sittner/ovng-build/README.md

OVNG-BUILD
==========
This repo contains the stuff to build a OpenVarioNG:

- KiCad project for the PCB
- FreeCAD drawing that includes the sensor distribution block and a printable housing
- buildroot env to build the sd card image for installation
