sittner/ovng-build/electronics/partlist.ods

Item | Qty | Reference(s) | Value | LibPart | Footprint | Manu | PartNo | Dist | DistPart
1 | 1 | BT501 | CR-1220 | Device:Battery_Cell | modusoft:BatteryHolder_HARWIN_S8411-45R_CR1220 | Harwin | S8411-45R | Mouser | 855-S8411-45R
2 | 25 | C101, C203, C210, C302, C307, C406, C407, C408, C409, C501, C502, C605, C606, C609, C801, C802, C803, C901, C902, C903, C917, C918, C919, C920, C924 | 100n | Device:C | Capacitor_SMD:C_0805_2012Metric |  | GPC0805104
3 | 8 | C102, C103, C104, C105, C106, C107, C108, C109 | 1000u/25V | Device:CP | Capacitor_THT:CP_Radial_D10.0mm_P5.00mm
4 | 4 | C202, C204, C205, C206 | 4u7/50V | Device:C | Capacitor_SMD:C_1206_3216Metric | Murata | GRM31CR71H475KA12L | Mouser | 81-GRM31CR71H475KA2L
5 | 1 | C207 | 1u/50V | Device:C | Capacitor_SMD:C_0805_2012Metric | Murata | GRM21BR71H105KA12L | Mouser | 81-GRM155R6YA105KE1D
6 | 1 | C208 | 10n | Device:C | Capacitor_SMD:C_0805_2012Metric |  | GPC0805103
7 | 1 | C209 | 180u/16V | Device:CP | Capacitor_SMD:CP_Elec_10x7.9 | Sanyo | 16SVP180MX | Mouser | 667-16SVP180MX
8 | 1 | C211 | 47u/16V | Device:C | Capacitor_SMD:C_1210_3225Metric | Murata | GRM32ER61C476KE15L | Mouser | 81-GRM32EC81C476KE5L
9 | 26 | C301, C303, C304, C305, C306, C308, C309, C310, C401, C402, C403, C404, C601, C602, C603, C604, C607, C608, C909, C910, C913, C914, C915, C916, C922, C923 | 1u | Device:C | Capacitor_SMD:C_0805_2012Metric |  | GPC0805105
10 | 2 | C904, C905 | 2u2 | Device:C | Capacitor_SMD:C_0805_2012Metric |  | GPC0805225
11 | 2 | C906, C921 | 10u | Device:C | Capacitor_SMD:C_0805_2012Metric | Murata | GRM21BR61C106KE15K | Mouser | 81-GRM21BR61C106KE5K
12 | 2 | C907, C908 | 2n2 | Device:C | Capacitor_SMD:C_0805_2012Metric |  | GPC0805222
13 | 2 | C911, C912 | 470n | Device:C | Capacitor_SMD:C_0805_2012Metric |  | GPC0805474
14 | 1 | D101 | S3BB-13-F | Device:D | Diode_SMD:D_SMB | Diodes Incorporated | ES3BB-13-F | Mouser | 621-ES3BB-F
15 | 1 | D102 | VS-20BQ030HM3/5BT | Device:D_Schottky | Diode_SMD:D_SMB | Vishay Semiconductors | VS-20BQ030HM3/5BT | Mouser | 78-VS-20BQ030HM35BT
16 | 1 | D201 | SS36-E3/57T | Device:D_Schottky | Diode_SMD:D_SMC | Vishay Semiconductors | SS36-E3/57T | Mouser | 625-SS36-E3
17 | 4 | D301, D302, D303, D304 | S1BB-13-F | Device:D | Diode_SMD:D_SMB | Diodes Incorporated | S1BB-13-F | Mouser | 621-S1BB-F
18 | 1 | D901 | PESD3V3L4UG | Power_Protection:PESD3V3L4UG | Package_TO_SOT_SMD:SOT-353_SC-70-5 | Nexperia | PESD3V3L4UG,115 | Mouser | 771-PESD3V3L4UG-T/R
19 | 1 | D902 | MBR0540 | Device:D_Schottky | Diode_SMD:D_SOD-123 | ON Semiconductor | MBR0540T1G | Mouser | 863-MBR0540T1G
20 | 1 | D903 | MM3Z24VT1G | Device:D_Zener | Diode_SMD:D_SOD-323 | ON Semiconductor | MM3Z24VT1G | Mouser | 863-MM3Z24VT1G
21 | 1 | F101 | 1.5A | Device:Polyfuse | Fuse:Fuse_2920_7451Metric | Littelfuse | 2920L150DR | Mouser | 576-2920L150
22 | 5 | F301, F302, F303, F304, F801 | 300mA | Device:Polyfuse | Fuse:Fuse_1812_4532Metric | Littelfuse | MINISMDC030F-2 | Mouser | 650-MINISMDC030F-2
24 | 1 | J101 | Power 12V | Connector:Conn_01x02_Male | modusoft:TerminalBlock_Phoenix_PTSM-0,5-2-HH-2.5-SMD_1x02-1MP_P2.50mm_Vertical | Phoenix | 1778764 | Mouser | 651-1778764
 |  |  |  |  |  | Phoenix | 1778832 | Mouser | 651-1778832
25 | 1 | J301 | COM1 | Connector:8P8C | modusoft:Modular-MEBP8-8S |  |  | Reichelt | MEBP 8-8S
26 | 1 | J302 | COM2 | Connector:8P8C | modusoft:Modular-MEBP8-8S |  |  | Reichelt | MEBP 8-8S
27 | 1 | J303 | COM3 | Connector:8P8C | modusoft:Modular-MEBP8-8S |  |  | Reichelt | MEBP 8-8S
28 | 1 | J304 | COM4 | Connector:8P8C | modusoft:Modular-MEBP8-8S |  |  | Reichelt | MEBP 8-8S
29 | 1 | J701 | BeagleBone J9 | Connector_Generic:Conn_02x23_Odd_Even | Connector_PinSocket_2.54mm:PinSocket_2x23_P2.54mm_Vertical
30 | 1 | J702 | BeagleBone J8 | Connector_Generic:Conn_02x23_Odd_Even | Connector_PinSocket_2.54mm:PinSocket_2x23_P2.54mm_Vertical
31 | 1 | J705 | BeagleBone J1 | Connector_Generic:Conn_01x06 | Connector_PinHeader_2.54mm:PinHeader_1x06_P2.54mm_Vertical
32 | 1 | J801 | OneWire | Connector:4P4C | modusoft:Modular-MEBP4-4S |  |  | Reichelt | MEBP 4-4S
33 | 1 | J802 | ENC0 | Connector:4P4C | modusoft:Modular-MEBP4-4S |  |  | Reichelt | MEBP 4-4S
34 | 1 | J803 | ENC1 | Connector:4P4C | modusoft:Modular-MEBP4-4S |  |  | Reichelt | MEBP 4-4S
35 | 1 | J901 | Audio Out | Connector:6P6C | modusoft:Modular-MEBP6-6S |  |  | Reichelt | MEBP 6-6S
36 | 1 | J902 | DISP | Connector_Generic:Conn_01x40 | Connector_FFC-FPC:TE_4-1734839-0_1x40-1MP_P0.5mm_Horizontal | TE Connectivity | 4-1734592-0 | Mouser | 571-4-1734592-0
37 | 2 | L201, L203 | 600R@100MHz/2A | Device:L_Core_Ferrite | modusoft:WE_742792040 | Würth | WE_CBF 742792040 | Mouser | 710-742792040
38 | 1 | L202 | 22u | Device:L_Core_Ferrite | Inductor_SMD:L_Wuerth_WE-PDF_Handsoldering | Würth | WE_PDF 7447798221 | Mouser | 710-7447798221
39 | 4 | L401, L601, L602, L603 | 1k@100MHz | Device:L_Core_Ferrite | Inductor_SMD:L_0805_2012Metric | Würth | 742792096 | Mouser | 710-742792096
40 | 1 | L901 | 10u | Device:L_Core_Ferrite | Inductor_SMD:L_Wuerth_MAPI-2510 | Wurth Elektronik | 74404024100 | Mouser | 710-74404024100
41 | 1 | Q301 | BC846 | Transistor_BJT:BC846 | Package_TO_SOT_SMD:SOT-23 | ON Semiconductor | BC846BLT1G | Mouser | 863-BC846BLT1G
42 | 1 | Q801 | BSS84 | Transistor_FET:BSS84 | Package_TO_SOT_SMD:SOT-23 | ON Semiconductor | BSS84 | Mouser | 512-BSS84
43 | 1 | R101 | 120k | Device:R | Resistor_SMD:R_0805_2012Metric |  | GPR0805120k
44 | 13 | R102, R301, R601, R602, R603, R604, R605, R606, R802, R803, R901, R909, R943 | 10k | Device:R | Resistor_SMD:R_0805_2012Metric |  | GPR080510k
45 | 4 | R103, R104, R402, R403 | 4k7 | Device:R | Resistor_SMD:R_0805_2012Metric |  | GPR08054k7
46 | 1 | R201 | 61k9 | Device:R | Resistor_SMD:R_0805_2012Metric | Panasonic | ERJ-6ENF6192V | Mouser | 667-ERJ-6ENF6192V
47 | 1 | R202 | 82k | Device:R | Resistor_SMD:R_0805_2012Metric |  | GPR080582k
48 | 2 | R203, R906 | 20k | Device:R | Resistor_SMD:R_0805_2012Metric |  | GPR080520k
49 | 7 | R302, R303, R907, R908, R910, R911, R941 | 100k | Device:R | Resistor_SMD:R_0805_2012Metric |  | GPR0805100k
50 | 2 | R401, R801 | 200k | Device:R | Resistor_SMD:R_0805_2012Metric |  | GPR0805200k
51 | 3 | R804, R912, R913 | 100R | Device:R | Resistor_SMD:R_0805_2012Metric |  | GPR0805100R
52 | 1 | R805 | 22R | Device:R | Resistor_SMD:R_0805_2012Metric |  | GPR080522R
53 | 2 | R902, R903 | 470R | Device:R | Resistor_SMD:R_0805_2012Metric |  | GPR0805470R
54 | 2 | R904, R905 | 27k | Device:R | Resistor_SMD:R_0805_2012Metric |  | GPR080527k
55 | 1 | R942 | 2R7 | Device:R | Resistor_SMD:R_0805_2012Metric |  | GPR08052R7
56 | 5 | RN801, RN802, RN803, RN804, RN805 | 22R | Device:R_Pack04 | Resistor_SMD:R_Array_Concave_4x0603 | Panasonic | EXB-V8V220JV | Mouser | 667-EXB-V8V220JV
57 | 1 | U201 | LM22670M-5_0 | mds-vreg:LM22670M-5_0 | modusoft:HSOP-8-1EP_3.9x4.9mm_P1.27mm_EP2.41x3.1mm_ThermalVias | Texas Instruments | LM22670MRE-5.0/NOPB | Mouser | 926-LM22670MRE50NOPB
58 | 2 | U301, U302 | MAX3232 | Interface_UART:MAX3232 | Package_SO:SOIC-16_3.9x9.9mm_P1.27mm | Texas Instruments | MAX3232EID | Mouser | 595-MAX3232EID
59 | 2 | U401, U402 | MCP1700-1802E_SOT23 | Regulator_Linear:MCP1700-1802E_SOT23 | Package_TO_SOT_SMD:SOT-23 | Microchip Technology | MCP1700T-1802E/TT | Mouser | 579-MCP1700T1802E/TT
60 | 2 | U403, U801 | PCA9306 | Interface:PCA9306 | Package_SO:SSOP-8_2.95x2.8mm_P0.65mm | Texas Instruments | PCA9306DCTR | Mouser | 595-PCA9306DCTR
61 | 1 | U404 | ICM20948 | mds-misc:ICM20948 | modusoft:QFN-24-1EP_3x3mm_P0.4mm_EP1.75x1.6mm_NP | TDK InvenSense | ICM-20948 | Mouser | 410-ICM-20948
62 | 1 | U501 | DS1338-33 | Timer_RTC:DS1307Z+ | Package_SO:SOIC-8_3.9x4.9mm_P1.27mm | Maxim Integrated | DS1338Z-33+T&R | Mouser | 700-DS1338Z-33T&R
63 | 1 | U502 | 24LC01 | Memory_EEPROM:24LC01 | Package_SO:SOIC-8_3.9x4.9mm_P1.27mm | Microchip Technology | 24LC01B-I/SN | Mouser | 579-24LC01B-I/SN
64 | 4 | U601, U602, U605, U902 | MCP1700-3302E_SOT23 | Regulator_Linear:MCP1700-3302E_SOT23 | Package_TO_SOT_SMD:SOT-23 | Microchip Technology | MCP1700T-3302E/TT | Mouser | 579-MCP1700T3302E/TT
65 | 2 | U603, U604 | MS5611 | mds-misc:MS5611 | Package_LGA:LGA-8_3x5mm_P1.25mm | Measurement Specialties | MS561101BA03-50 | Mouser | 824-MS561101BA03-50
66 | 1 | U606 | AMS5915 | mds-misc:AMS5915 | modusoft:AMS5915 |  |  | Amsys GmbH & Co. KK | AMS5915-0050-D-N
67 | 1 | U802 | DS2482-100 | mds-misc:DS2482-100 | Package_SO:SOIC-8_3.9x4.9mm_P1.27mm | Maxim Integrated | DS2482S-100+ | Mouser | 700-DS2482S-100
68 | 1 | U901 | PCM5101A | Audio:PCM5101 | Package_SO:TSSOP-20_4.4x6.5mm_P0.65mm | Texas Instruments | PCM5101APWR | Mouser | 595-PCM5101APWR
69 | 1 | U903 | LM4990MM | Amplifier_Audio:LM4990MM | Package_SO:TSSOP-8_3x3mm_P0.65mm | Texas Instruments | LM4990MM/NOPB | Mouser | 926-LM4990MM/NOPB
70 | 1 | U904 | TS3A24159DGSR | Analog_Switch:TS3A24159DGSR | Package_SO:TSSOP-10_3x3mm_P0.5mm | Texas Instruments | TS3A24159DGSR | Mouser | 595-TS3A24159DGSR
71 | 1 | U905 | SN65HVDA540 | Interface_CAN_LIN:TJA1049T-3 | Package_SO:SOIC-8_3.9x4.9mm_P1.27mm | Texas Instruments | SN65HVDA540QDR | Mouser | 595-SN65HVDA540QDR
72 | 1 | U906 | FAN5333B | Regulator_Switching:SC4503TSK | Package_TO_SOT_SMD:TSOT-23-5 | ON Semiconductor | FAN5333BSX | Mouser | 512-FAN5333BSX
73 | 1 | Y501 | 32.768kHz/12.5pF | Device:Crystal | Crystal:Crystal_SMD_3215-2Pin_3.2x1.5mm | ECS | ECS-.327-12.5-34B-TR | Mouser | 520-327-12.5-34B
