sittner/ovng-build/mechanics/sensor-block.stp

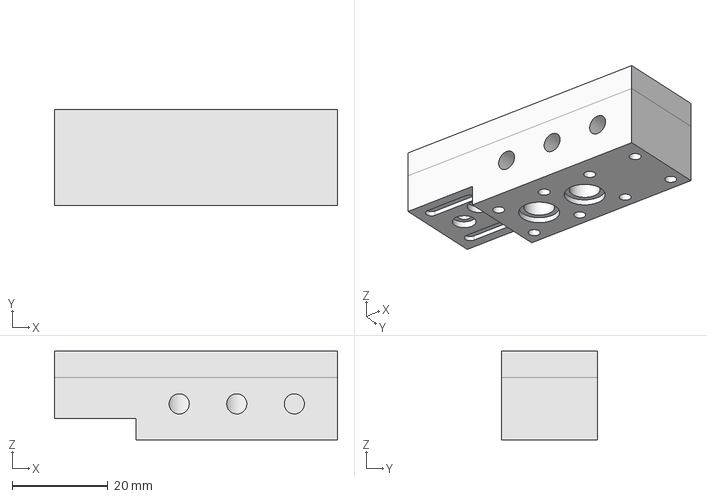
[picture p1: CAD file, 2022-04-04]
mechanics/sensor-block.stp
59.0 x 20.0 x 18.5 mm
