sittner/ovng-build/mechanics/housing-base.stl

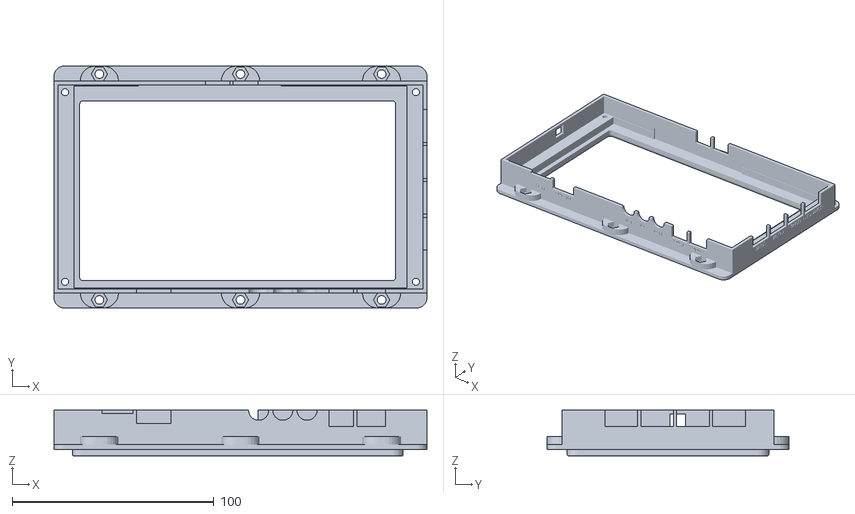
[picture p2: CAD file, 2020-12-04]
mechanics/housing-base.stl
185.0 x 120.0 x 22.6
