sittner/ovng-build/mechanics/housing-top.stl

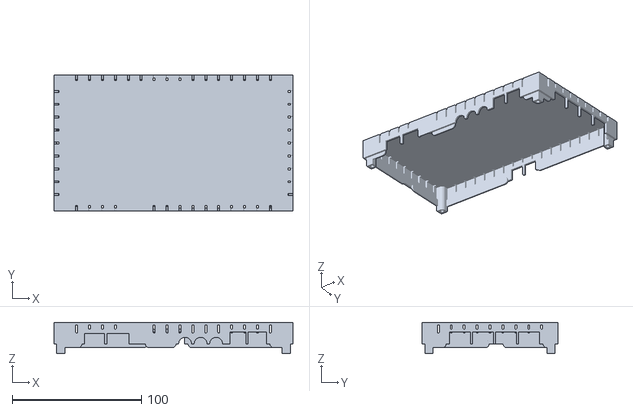
[picture p3: CAD file, 2020-12-04]
mechanics/housing-top.stl
185.0 x 105.0 x 24.0
