sittner/ovng-build/mechanics/display-spacer.stl

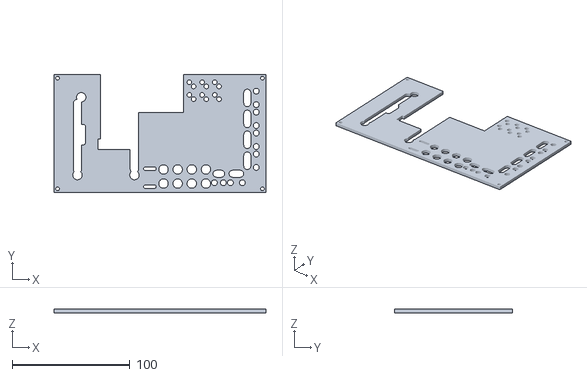
[picture p4: CAD file, 2020-12-01]
mechanics/display-spacer.stl
180.0 x 100.0 x 3.00
