sittner/ovng-build/(list of files, cad)

Other CAD files:
mechanics/SensorBlock.FCStd
mechanics/sensor-block.stl
