sittner/ovng-build/electronics/schematics.pdf

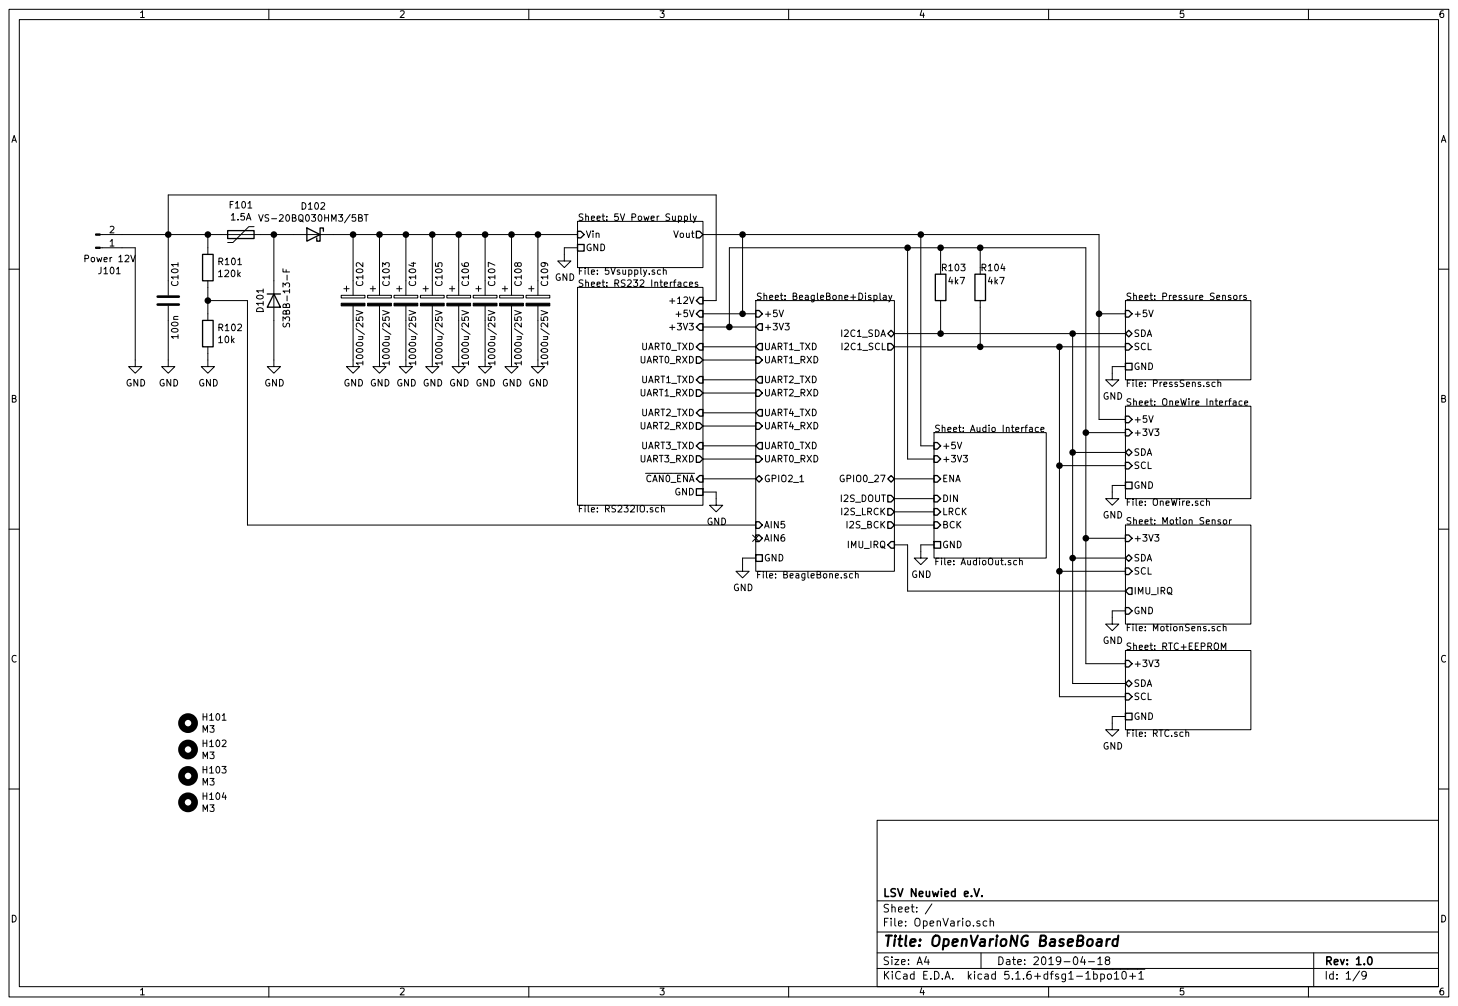
[picture p5: page 1]

SCL Sheet: Pressure Sensors File: PressSens.sch +5V

Sheet: OneWire Interface File: OneWire.sch GND
+3V3 SDA
SCL Sheet: Motion Sensor File: MotionSens.sch +3V3 GND

Sheet: Audio Interface File: AudioOut.sch +5V GND

Sheet: RTC+EEPROM
File: RTC.sch +3V3 GND
SDA

File: OpenVario.sch Sheet: / LSV Neuwied e.V.

Id: 1/9 Title: OpenVarioNG BaseBoard

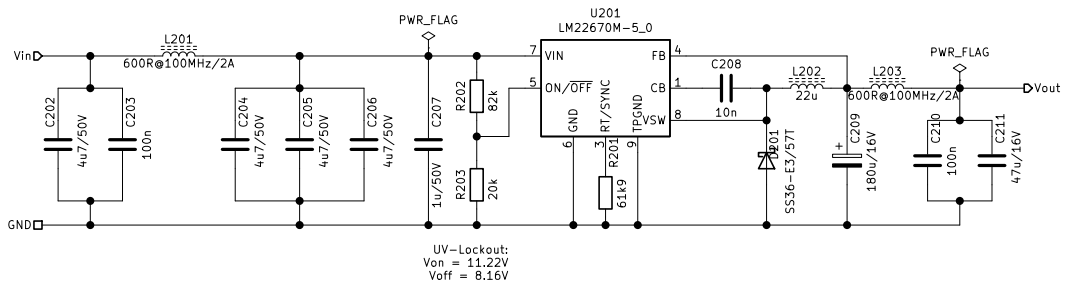
[picture p6: page 2]

3 FB 4 ON/OFF 5 GND

File: 5Vsupply.sch
Id: 2/9 Title: OpenVarioNG BaseBoard

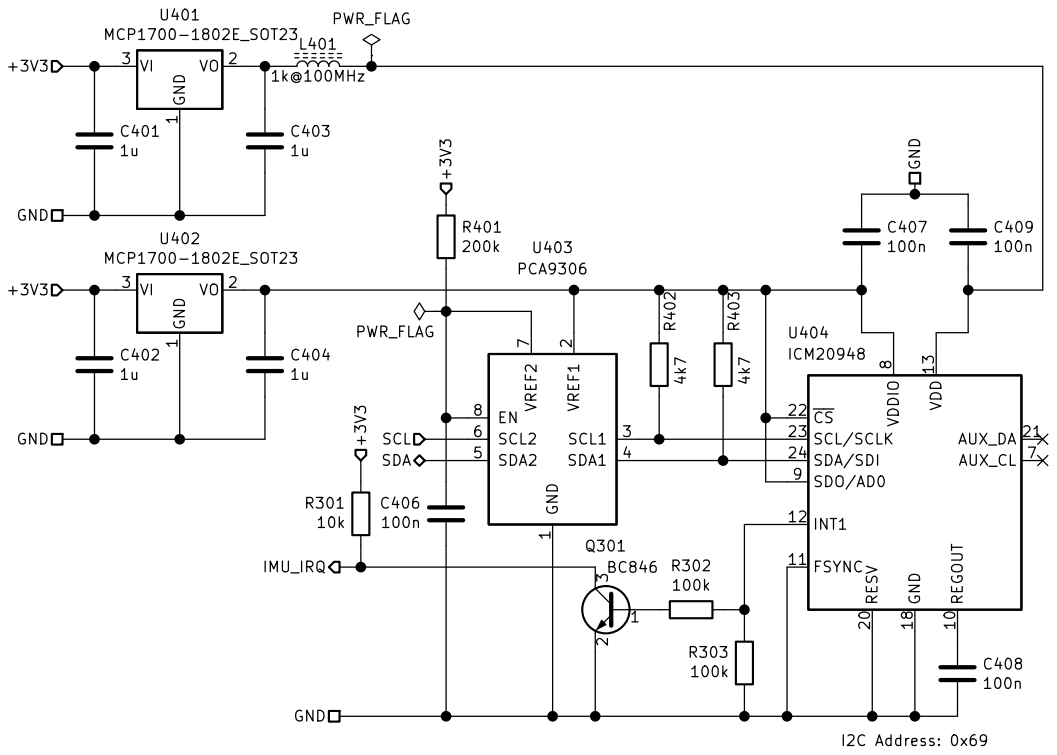
[picture p7: page 3]

File: MotionSens.sch Sheet: /Motion Sensor/ LSV Neuwied e.V.

Id: 3/9 Title: OpenVarioNG BaseBoard

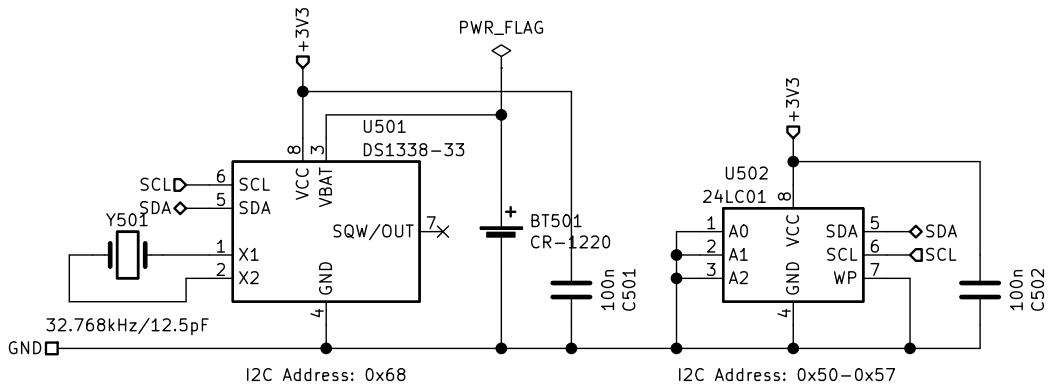
[picture p8: page 4]

4 SDA 5 SCL 6 SQW/OUT 7 VCC

4 SDA 5 SCL 6 WP 7 VCC

File: RTC.sch Sheet: /RTC+EEPROM/ LSV Neuwied e.V.

Id: 4/9 Title: OpenVarioNG BaseBoard

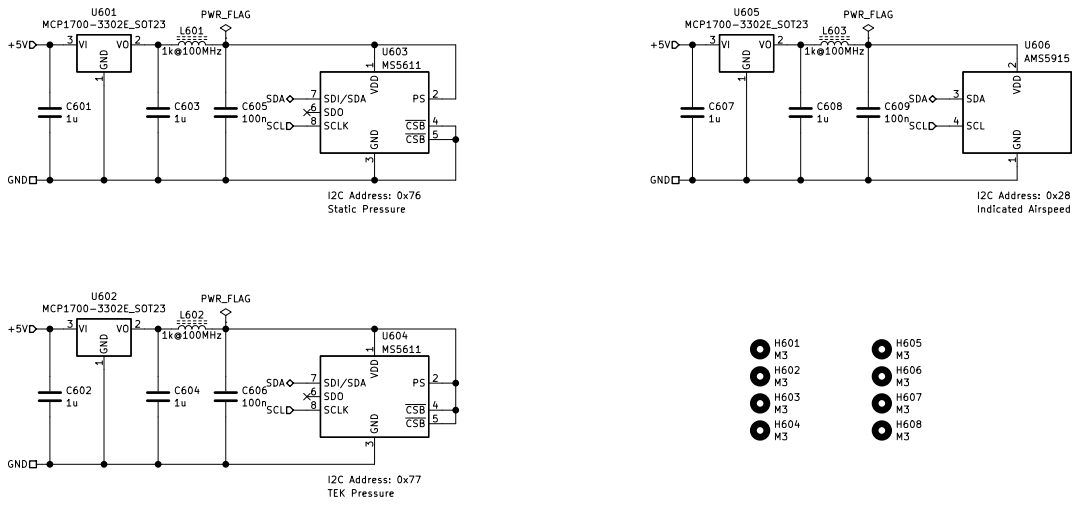
[picture p9: page 5]

3 CSB 4 CSB 5 SDO 6 SDI/SDA 7 SCLK 8 U603 MS5611 C601
100n GND

3 CSB 4 CSB 5 SDO 6 SDI/SDA 7 SCLK 8 U604 GND MS5611

File: PressSens.sch Sheet: /Pressure Sensors/ LSV Neuwied e.V.

Id: 5/9 Title: OpenVarioNG BaseBoard

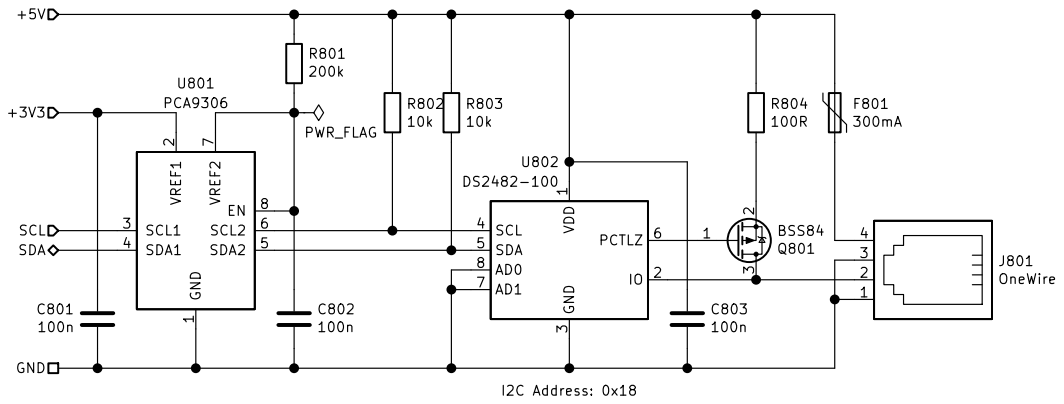
[picture p10: page 6]

File: OneWire.sch Sheet: /OneWire Interface/ LSV Neuwied e.V. VDD

Id: 6/9 Title: OpenVarioNG BaseBoard

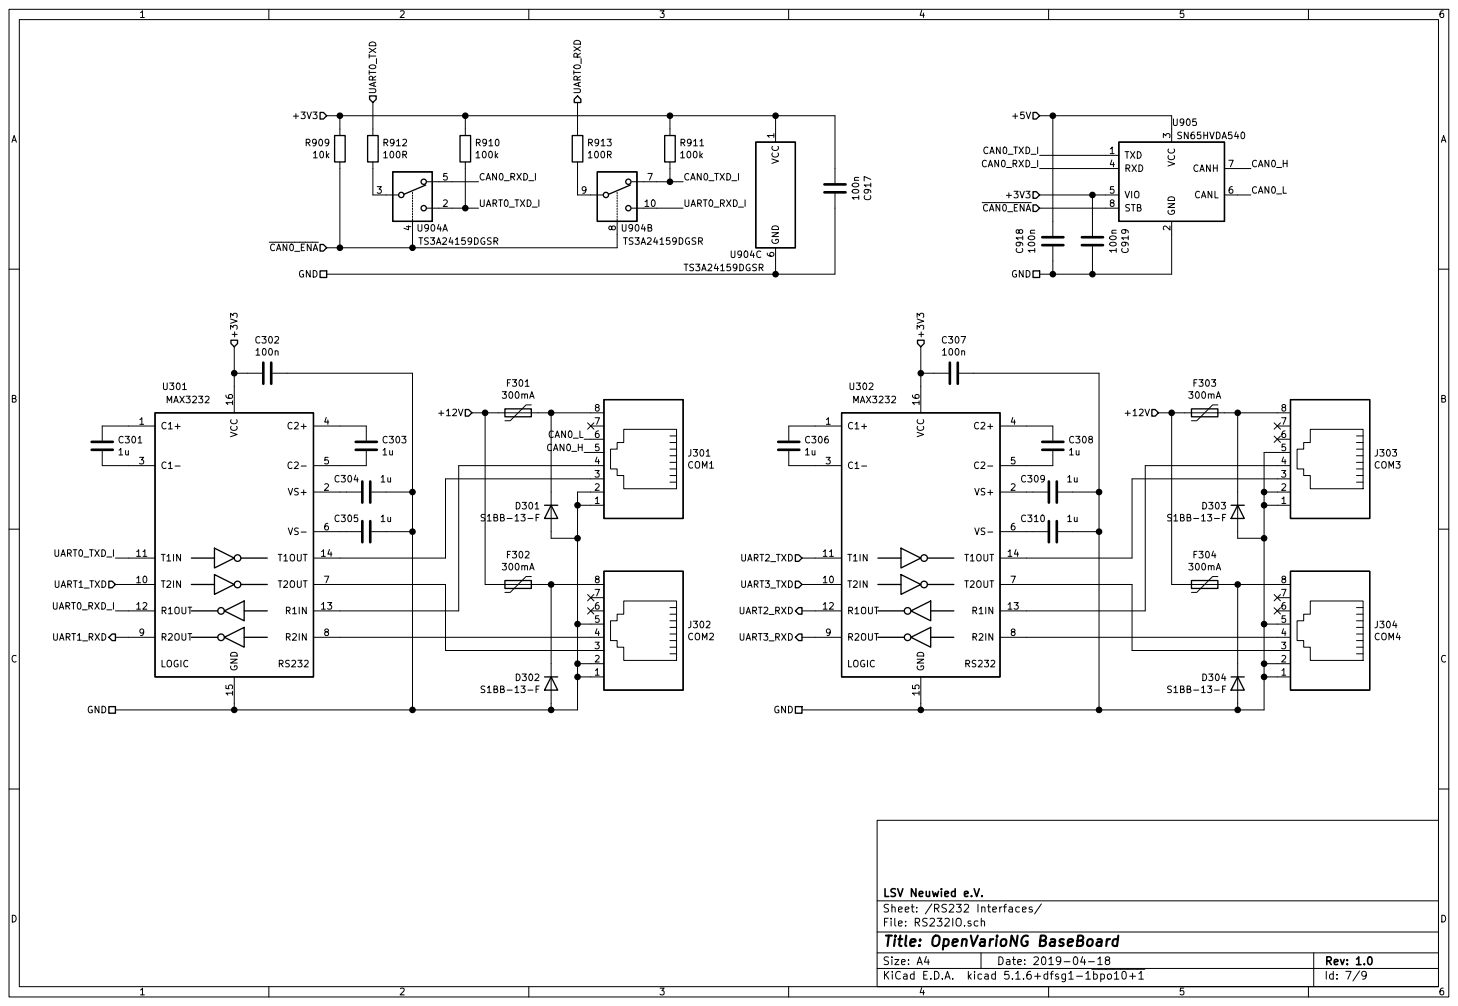
[picture p11: page 7]

3 RXD 4 VIO 5 CANL 6 CANH 7 STB 8 U905 SN65HVDA540 D303 S1BB-13-F

File: RS232IO.sch Sheet: /RS232 Interfaces/ LSV Neuwied e.V.

Id: 7/9 Title: OpenVarioNG BaseBoard

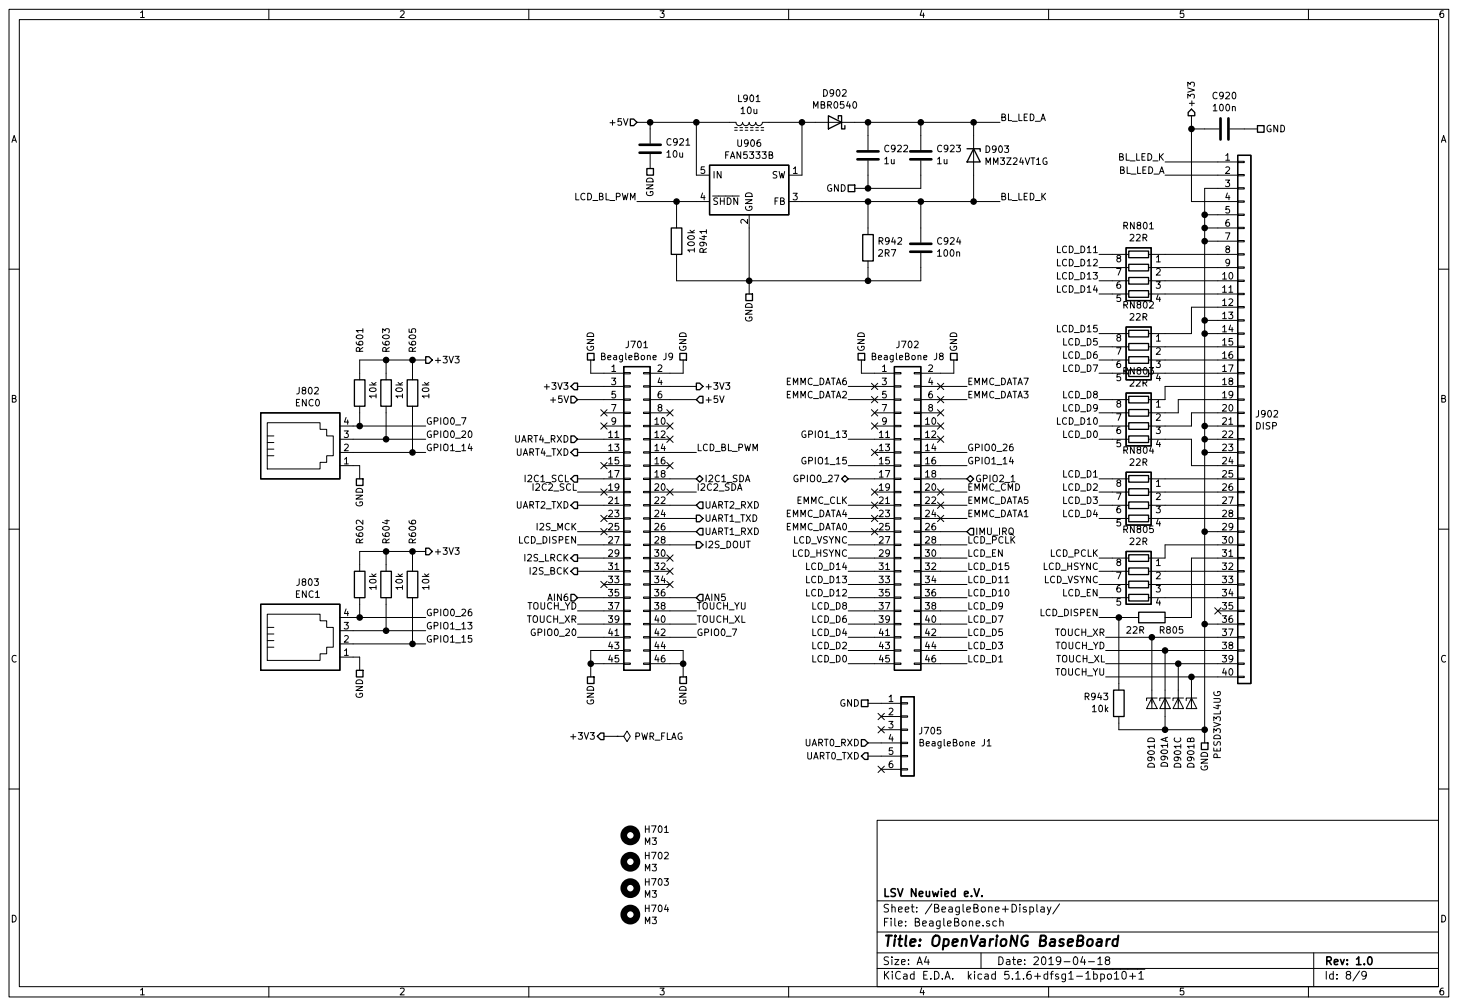
[picture p12: page 8]

394 16
4056789 17

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
File: BeagleBone.sch
Id: 8/9 Title: OpenVarioNG BaseBoard

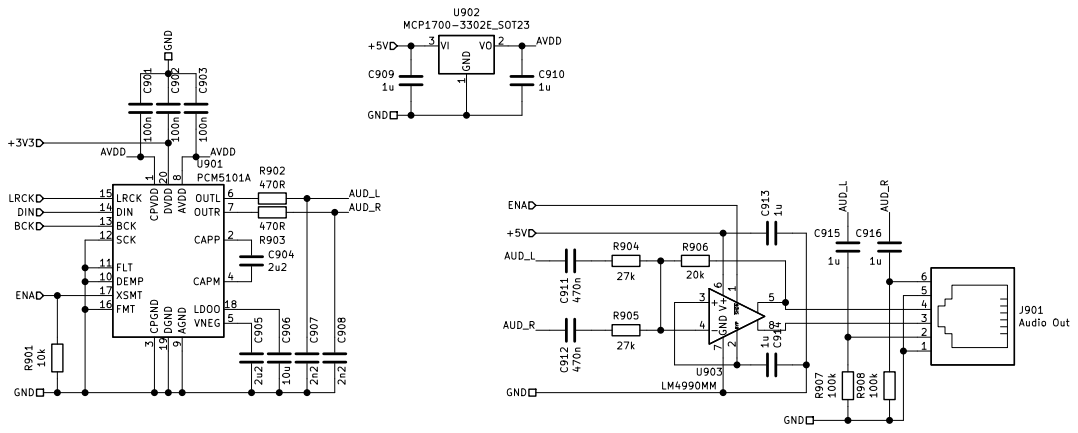
[picture p13: page 9]

1 DEMP 10 FLT 11 SCK 12 BCK 13 DIN 14

3 CAPM 4 VNEG 5 OUTL 6 OUTR 7 AVDD

Id: 9/9 Title: OpenVarioNG BaseBoard
