sittner/ovng-build/mechanics/sensor-block.pdf

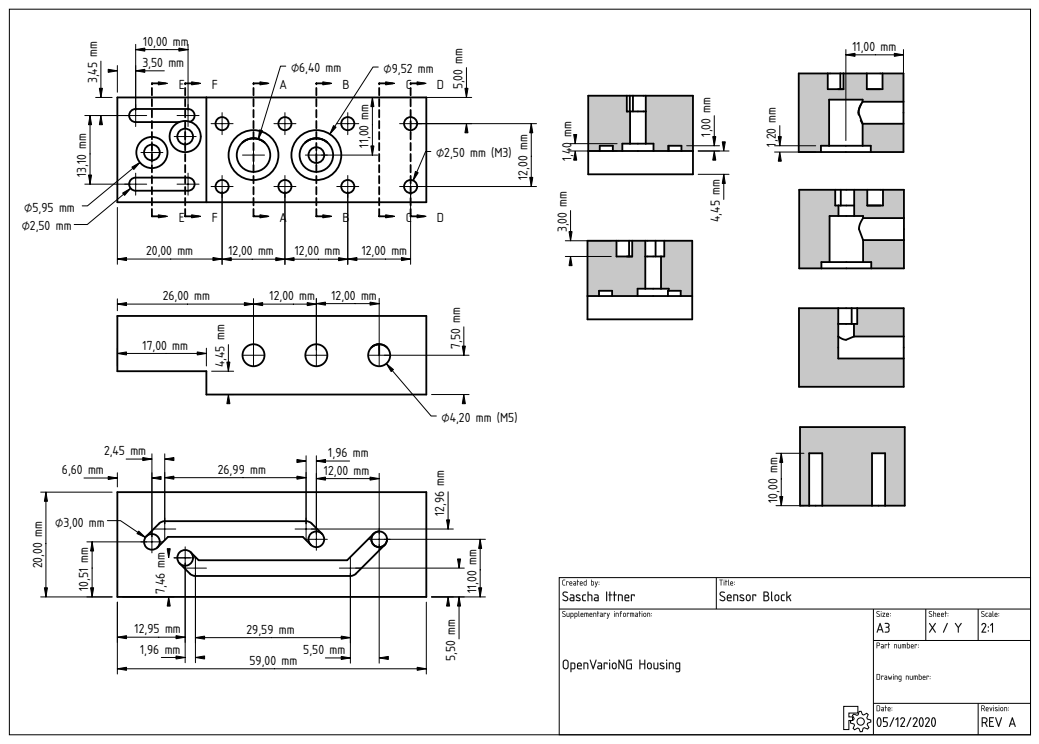
[picture p14: page 1]
