sittner/ovng-build/electronics/placement.pdf

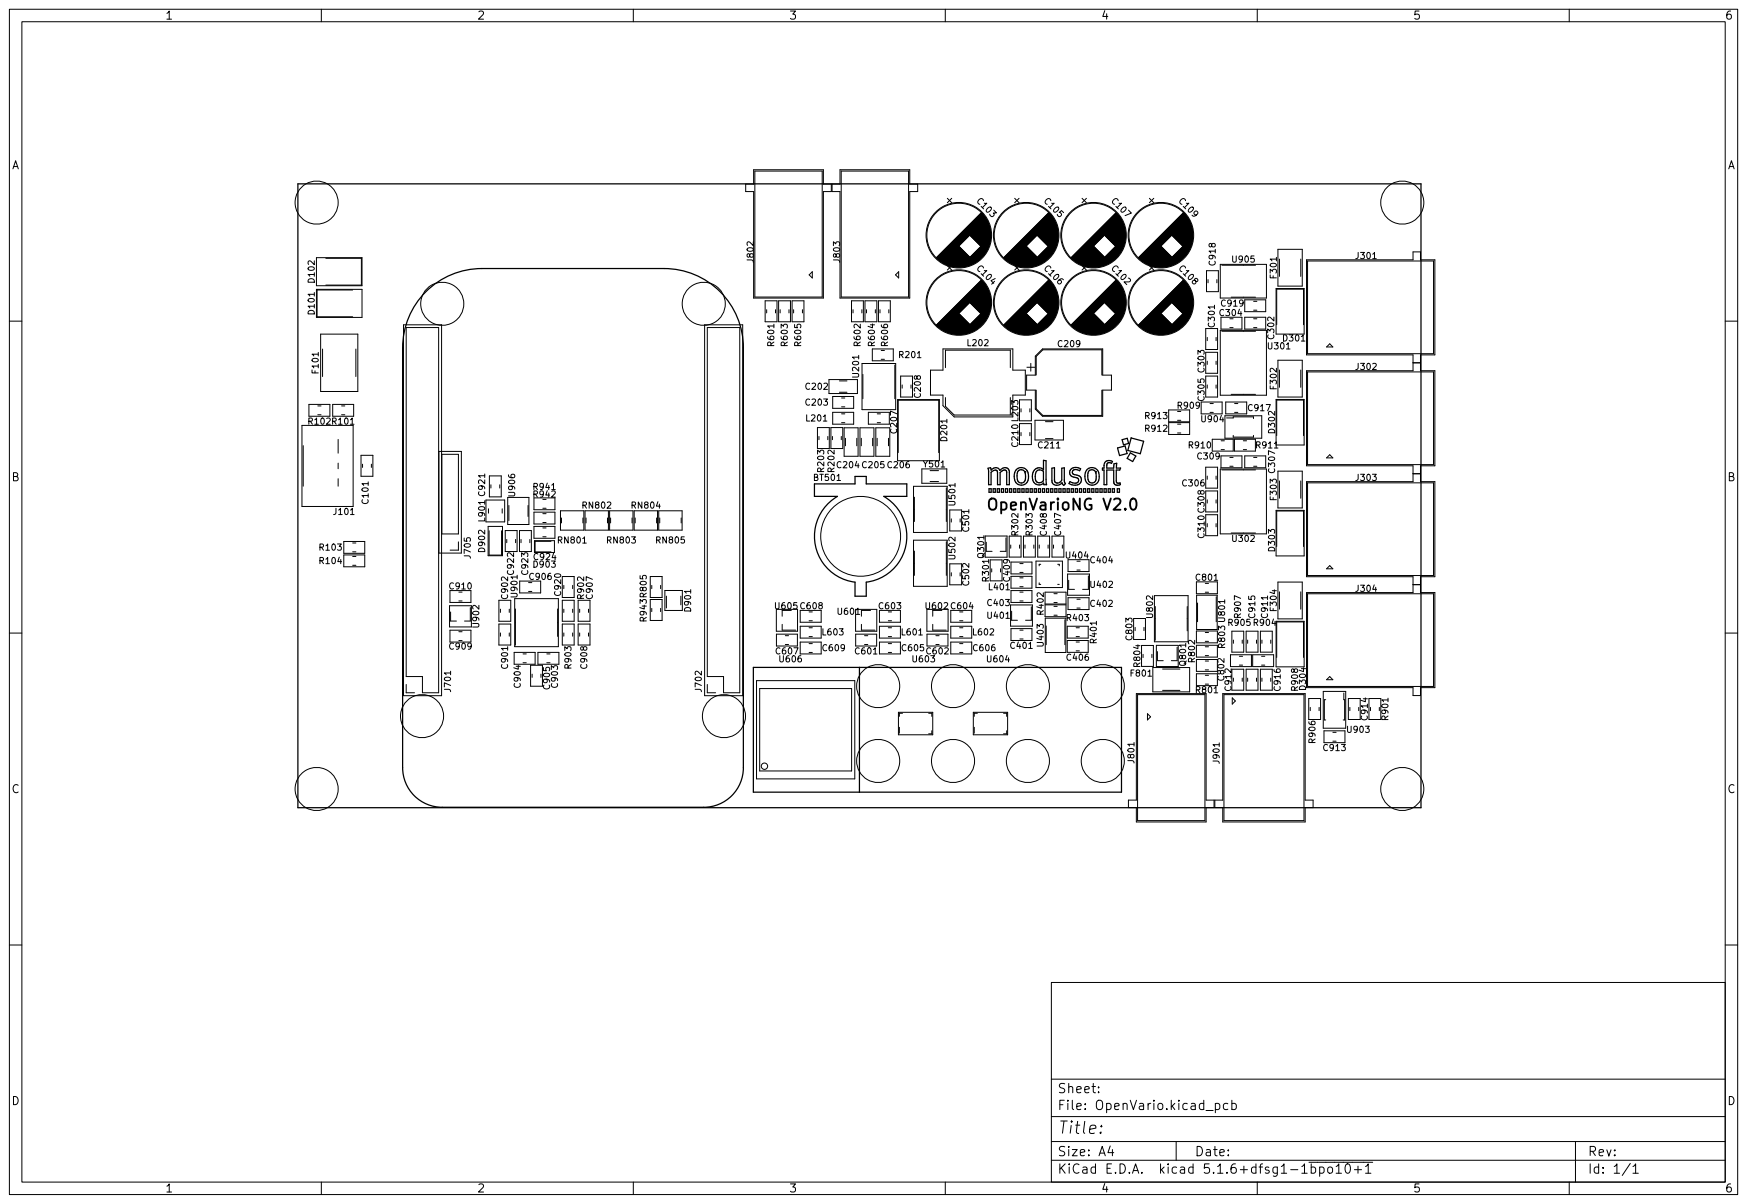
[picture p15: page 1]

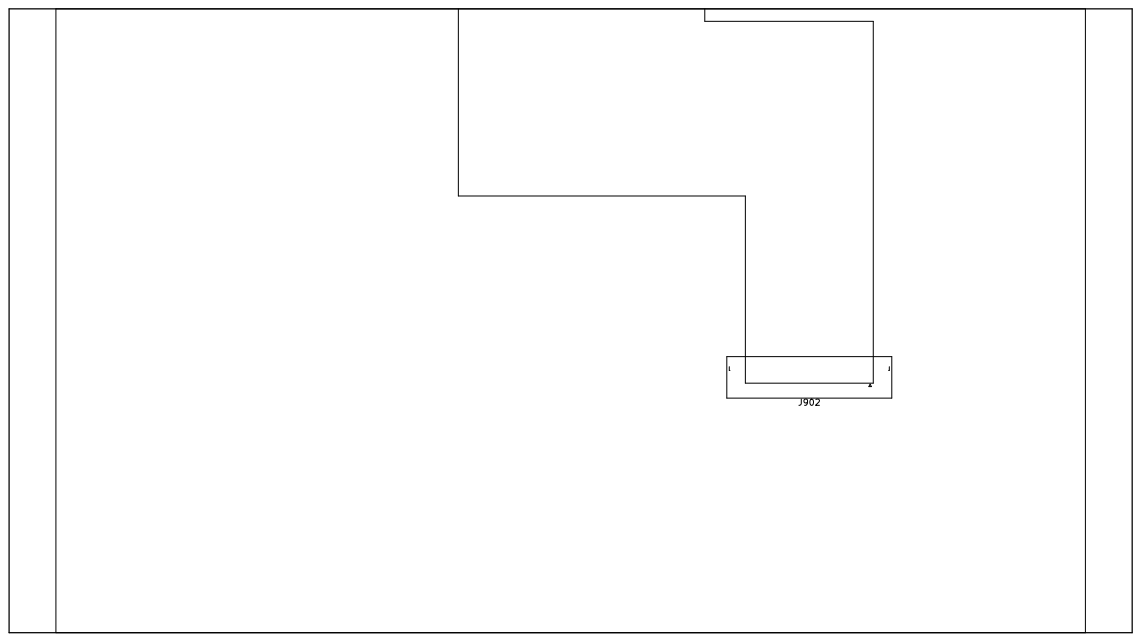
[picture p16: page 2]
