sittner/ovng-build/electronics/project/OpenVario.kicad_pcb

## KiCad design electronics/project/OpenVario.kicad_pcb (2022-04-04)

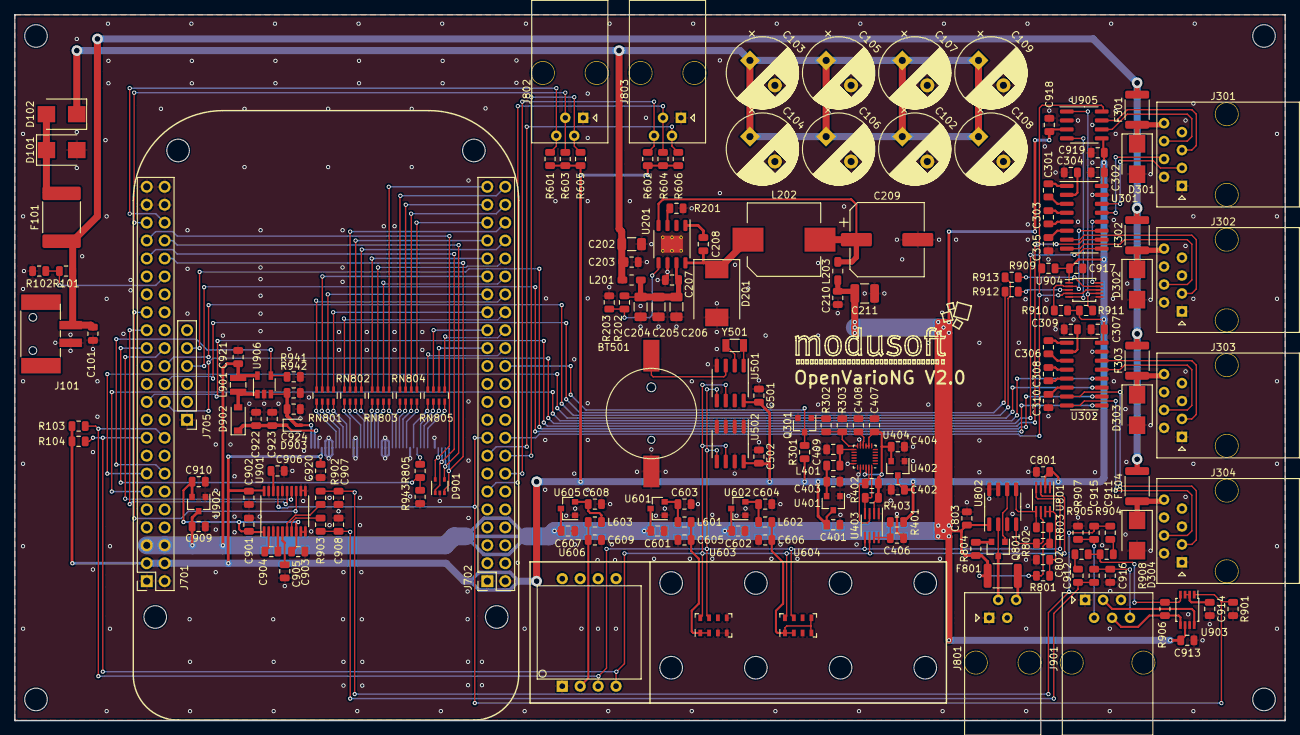
[picture p17: board OpenVario.kicad_pcb from above]

Board: 2 copper layers, 180.0 x 100.0 mm, 200 parts (1 on the bottom side), 159 nets.

Parts:
BT501: CR-1220; BatteryHolder_HARWIN_S8411-45R_CR1220
C101, C203, C210, C302, C307, C406, C407, C408, C409, C501, C502, C605, C606, C609, C801, C802, C803, C901, C902, C903, C917, C918, C919, C920, C924: 100n; C_0805_2012Metric
C102, C103, C104, C105, C106, C107, C108, C109: 1000u/25V; CP_Radial_D10.0mm_P5.00mm
C202, C204, C205, C206: 4u7/50V; C_1206_3216Metric
C207: 1u/50V; C_0805_2012Metric
C208: 10n; C_0805_2012Metric
C209: 180u/16V; CP_Elec_10x7.9
C211: 47u/16V; C_1210_3225Metric
C301, C303, C304, C305, C306, C308, C309, C310, C401, C402, C403, C404, C601, C602, C603, C604, C607, C608, C909, C910, C913, C914, C915, C916, C922, C923: 1u; C_0805_2012Metric
C904, C905: 2u2; C_0805_2012Metric
C906, C921: 10u; C_0805_2012Metric
C907, C908: 2n2; C_0805_2012Metric
C911, C912: 470n; C_0805_2012Metric
D101: S3BB-13-F; D_SMB
D102: VS-20BQ030HM3/5BT; D_SMB
D201: SS36-E3/57T; D_SMC
D301, D302, D303, D304: S1BB-13-F; D_SMB
D901: PESD3V3L4UG; SOT-353_SC-70-5
D902: MBR0540; D_SOD-123
D903: MM3Z24VT1G; D_SOD-323
F101: 1.5A; Fuse_2920_7451Metric
F301, F302, F303, F304, F801: 300mA; Fuse_1812_4532Metric
H101, H102, H103, H104, H601, H602, H603, H604, H605, H606, H607, H608, H701, H702, H703, H704: M3; MountingHole_3.2mm_M3
J101: Power 12V; TerminalBlock_Phoenix_PTSM-0,5-2-HH-2.5-SMD_1x02-1MP_P2.50m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
J301: COM1; Modular-MEBP8-8S
J302: COM2; Modular-MEBP8-8S
J303: COM3; Modular-MEBP8-8S
J304: COM4; Modular-MEBP8-8S
J701: BeagleBone J9; PinSocket_2x23_P2.54mm_Vertical
J702: BeagleBone J8; PinSocket_2x23_P2.54mm_Vertical
J705: BeagleBone J1; PinHeader_1x06_P2.54mm_Vertical
J801: OneWire; Modular-MEBP4-4S
J802: ENC0; Modular-MEBP4-4S
J803: ENC1; Modular-MEBP4-4S
J901: Audio Out; Modular-MEBP6-6S
J902: DISP; TE_4-1734839-0_1x40-1MP_P0.5mm_Horizontal
L201, L203: 600R@100MHz/2A; WE_742792040
L202: 22u; L_Wuerth_WE-PDF_Handsoldering
L401, L601, L602, L603: 1k@100MHz; L_0805_2012Metric
L901: 10u; L_Wuerth_MAPI-2512
Q301: BC846; SOT-23
Q801: BSS84; SOT-23
R101: 120k; R_0805_2012Metric
R102, R301, R601, R602, R603, R604, R605, R606, R802, R803, R901, R909, R943: 10k; R_0805_2012Metric
R103, R104, R402, R403: 4k7; R_0805_2012Metric
R201: 61k9; R_0805_2012Metric
R202: 82k; R_0805_2012Metric
R203, R906: 20k; R_0805_2012Metric
R302, R303, R907, R908, R910, R911, R941: 100k; R_0805_2012Metric
R401, R801: 200k; R_0805_2012Metric
R804, R912, R913: 100R; R_0805_2012Metric
R805: 22R; R_0805_2012Metric
R902, R903: 470R; R_0805_2012Metric
R904, R905: 27k; R_0805_2012Metric
R942: 2R7; R_0805_2012Metric
RN801, RN802, RN803, RN804, RN805: 22R; R_Array_Concave_4x0603
U201: LM22670M-5_0; HSOP-8-1EP_3.9x4.9mm_P1.27mm_EP2.41x3.1mm_ThermalVias
U301, U302: MAX3232; SOIC-16_3.9x9.9mm_P1.27mm
U401, U402: MCP1700-1802E_SOT23; SOT-23
U403, U801: PCA9306; SSOP-8_2.95x2.8mm_P0.65mm
U404: ICM20948; QFN-24-1EP_3x3mm_P0.4mm_EP1.75x1.6mm_NP
U501: DS1338-33; SOIC-8_3.9x4.9mm_P1.27mm
U502: 24LC01; SOIC-8_3.9x4.9mm_P1.27mm
U601, U602, U605, U902: MCP1700-3302E_SOT23; SOT-23
U603, U604: MS5611; LGA-8_3x5mm_P1.25mm
U606: AMS5915
U802: DS2482-100; SOIC-8_3.9x4.9mm_P1.27mm
U901: PCM5101A; TSSOP-20_4.4x6.5mm_P0.65mm
U903: LM4990MM; TSSOP-8_3x3mm_P0.65mm
U904: TS3A24159DGSR; TSSOP-10_3x3mm_P0.5mm
U905: SN65HVDA540; SOIC-8_3.9x4.9mm_P1.27mm
U906: FAN5333B; TSOT-23-5
Y501: 32.768kHz/12.5pF; Crystal_SMD_3215-2Pin_3.2x1.5mm

Connections:
/5V Power Supply/Vin: C102.1, C103.1, C104.1, C105.1, C106.1, C107.1, C108.1, C109.1, C202.1, C203.1, D102.1, L201.1
/Audio Interface/+3V3: C302.2, C307.2, C401.1, C402.1, C501.2, C502.2, C801.2, C902.2, C917.2, C919.2, C920.2, J701.3, J701.4, J902.4, R103.1, R104.1, R301.2, R401.1, R601.1, R602.1, R603.1, R604.1, R605.1, R606.1, R909.1, R910.1, R911.1, U301.16, U302.16, U401.3, U402.3, U501.8, U502.8, U801.2, U901.20, U904.1, U905.5
/Audio Interface/+5V: C210.1, C211.1, C601.1, C602.1, C607.1, C803.2, C909.1, C913.1, C918.2, C921.2, F801.1, J701.5, J701.6, L203.2, L901.2, R801.2, R802.1, R803.1, R804.1, U601.3, U602.3, U605.3, U802.1, U902.3, U903.6, U905.3, U906.5
/Audio Interface/AUD_L: C907.1, C911.1, C915.1, R902.1
/Audio Interface/AUD_R: C908.1, C912.1, C916.1, R903.1
/Audio Interface/AVDD: C901.2, C903.2, C910.1, U901.1, U901.8, U902.2
/Audio Interface/BCK: J701.31, U901.13
/Audio Interface/DIN: J701.28, U901.14
/Audio Interface/ENA: J702.17, R901.2, U901.17, U903.1
/BeagleBone+Display/AIN5: J701.36, R101.2, R102.1
/BeagleBone+Display/BL_LED_A: C922.2, C923.2, D902.1, D903.1, J902.2
/BeagleBone+Display/BL_LED_K: C924.2, D903.2, J902.1, R942.2, U906.3
/BeagleBone+Display/GPIO0_7: J701.42, J802.4, R601.2
/BeagleBone+Display/GPIO0_20: J701.41, J802.3, R603.2
/BeagleBone+Display/GPIO0_26: J702.14, J803.4, R602.2
/BeagleBone+Display/GPIO1_13: J702.11, J803.3, R604.2
/BeagleBone+Display/GPIO1_14: J702.16, J802.2, R605.2
/BeagleBone+Display/GPIO1_15: J702.15, J803.2, R606.2
/BeagleBone+Display/GPIO2_1: J702.18, R909.2, U904.4, U904.8, U905.8
/BeagleBone+Display/I2C1_SCL: J701.17, R104.2, U403.6, U501.6, U502.6, U603.8, U604.8, U606.4, U801.3
/BeagleBone+Display/I2C1_SDA: J701.18, R103.2, U403.5, U501.5, U502.5, U603.7, U604.7, U606.3, U801.4
/BeagleBone+Display/I2S_LRCK: J701.29, U901.15
/BeagleBone+Display/IMU_IRQ: J702.26, Q301.3, R301.1
/BeagleBone+Display/LCD_BL_PWM: J701.14, R941.2, U906.4
/BeagleBone+Display/LCD_D0: J702.45, RN803.5
/BeagleBone+Display/LCD_D1: J702.46, RN804.8
/BeagleBone+Display/LCD_D2: J702.43, RN804.7
/BeagleBone+Display/LCD_D3: J702.44, RN804.6
/BeagleBone+Display/LCD_D4: J702.41, RN804.5
/BeagleBone+Display/LCD_D5: J702.42, RN802.7
/BeagleBone+Display/LCD_D6: J702.39, RN802.6
/BeagleBone+Display/LCD_D7: J702.40, RN802.5
/BeagleBone+Display/LCD_D8: J702.37, RN803.8
/BeagleBone+Display/LCD_D9: J702.38, RN803.7
/BeagleBone+Display/LCD_D10: J702.36, RN803.6
/BeagleBone+Display/LCD_D11: J702.34, RN801.8
/BeagleBone+Display/LCD_D12: J702.35, RN801.7
/BeagleBone+Display/LCD_D13: J702.33, RN801.6
/BeagleBone+Display/LCD_D14: J702.31, RN801.5
/BeagleBone+Display/LCD_D15: J702.32, RN802.8
/BeagleBone+Display/LCD_DISPEN: J701.27, R805.1, R943.2
/BeagleBone+Display/LCD_EN: J702.30, RN805.5
/BeagleBone+Display/LCD_HSYNC: J702.29, RN805.7
/BeagleBone+Display/LCD_PCLK: J702.28, RN805.8
/BeagleBone+Display/LCD_VSYNC: J702.27, RN805.6
/BeagleBone+Display/TOUCH_XL: D901.4, J701.40, J902.39
/BeagleBone+Display/TOUCH_XR: D901.5, J701.39, J902.37
/BeagleBone+Display/TOUCH_YD: D901.1, J701.37, J902.38
/BeagleBone+Display/TOUCH_YU: D901.3, J701.38, J902.40
/BeagleBone+Display/UART0_RXD: J705.4, U302.9
/BeagleBone+Display/UART0_TXD: J705.5, U302.10
/RS232 Interfaces/+12V: C101.1, F101.2, F301.2, F302.2, F303.2, F304.2, J101.2, R101.1
/RS232 Interfaces/CAN0_H: J301.5, U905.7
/RS232 Interfaces/CAN0_L: J301.6, U905.6
/RS232 Interfaces/CAN0_RXD_I: U904.5, U905.4
/RS232 Interfaces/CAN0_TXD_I: R911.2, U904.7, U905.1
/RS232 Interfaces/UART0_RXD: J701.26, R913.1
/RS232 Interfaces/UART0_RXD_I: U301.12, U904.10
/RS232 Interfaces/UART0_TXD: J701.24, R912.1
/RS232 Interfaces/UART0_TXD_I: R910.2, U301.11, U904.2
/RS232 Interfaces/UART1_RXD: J701.22, U301.9
/RS232 Interfaces/UART1_TXD: J701.21, U301.10
/RS232 Interfaces/UART2_RXD: J701.11, U302.12
/RS232 Interfaces/UART2_TXD: J701.13, U302.11
GND: BT501.2, C101.2, C102.2, C103.2, C104.2, C105.2, C106.2, C107.2, C108.2, C109.2, C202.2, C203.2, C204.2, C205.2, C206.2, C207.2, C209.2, C210.2, C211.2, C302.1, C304.1, C305.1, C307.1, C309.1, C310.1, C401.2, C402.2, C403.2, C404.2, C406.1, C407.1, C408.2, C409.1, C501.1, C502.1, C601.2, C602.2, C603.2, C604.2, C605.2, C606.2, C607.2, C608.2, C609.2, C801.1, C802.1, C803.1, C901.1, C902.1, C903.1, C905.2, C906.2, C907.2, C908.2, C909.2, C910.2, C913.2, C914.1, C917.1, C918.1, C919.1, C920.1, C921.1, C922.1, C923.1, C924.1, D101.2, D201.2, D301.2, D302.2, D303.2, D304.2, D901.2, J101.1, J301.1, J301.2, J302.1, J302.2, J302.5, J303.1, J303.2, J303.5, J304.1, J304.2, J304.5, J701.1, J701.2, J701.43, J701.44, J701.45, J701.46, J702.1, J702.2, J705.1, J801.1, J801.3, J802.1, J803.1, J901.1, J901.5, J902.3, J902.5, J902.6, J902.7, J902.13, J902.14, J902.21, J902.22, J902.23, J902.29, J902.36, Q301.2, R102.2, R201.2, R203.2, R303.1, R901.1, R907.1, R908.1, R941.1, R942.1, R943.1, U201.6, U201.9, U301.15, U302.15, U401.1, U402.1, U403.1, U404.11, U404.18, U404.20, U501.4, U502.1, U502.2, U502.3, U502.4, U502.7, U601.1, U602.1, U603.3, U603.4, U603.5, U604.3, U605.1, U606.1, U801.1, U802.3, U802.7, U802.8, U901.3, U901.9, U901.10, U901.11, U901.12, U901.16, U901.19, U902.1, U903.7, U904.6, U905.2, U906.2
unnamed: BT501.1, U501.3
unnamed: C204.1, C205.1, C206.1, C207.1, L201.2, R202.1, U201.7
unnamed: C208.1, D201.1, L202.1, U201.8
unnamed: C208.2, U201.1
unnamed: C209.1, L202.2, L203.1, U201.4
unnamed: C301.1, U301.1
unnamed: C301.2, U301.3
unnamed: C303.1, U301.4
unnamed: C303.2, U301.5
unnamed: C304.2, U301.2
unnamed: C305.2, U301.6
unnamed: C306.1, U302.1
unnamed: C306.2, U302.3
unnamed: C308.1, U302.4
unnamed: C308.2, U302.5
unnamed: C309.2, U302.2
unnamed: C310.2, U302.6
unnamed: C403.1, L401.1, U401.2
unnamed: C404.1, C407.2, R402.1, R403.1, U402.2, U403.2, U404.8, U404.9, U404.22
unnamed: C406.2, R401.2, U403.7, U403.8
unnamed: C408.1, U404.10
unnamed: C409.2, L401.2, U404.13
unnamed: C603.1, L601.1, U601.2
unnamed: C604.1, L602.1, U602.2
unnamed: C605.1, L601.2, U603.1, U603.2
unnamed: C606.1, L602.2, U604.1, U604.2, U604.4, U604.5
unnamed: C608.1, L603.1, U605.2
unnamed: C609.1, L603.2, U606.2
unnamed: C802.2, R801.1, U801.7, U801.8
unnamed: C904.1, U901.2
unnamed: C904.2, U901.4
unnamed: C905.1, U901.5
unnamed: C906.1, U901.18
unnamed: C911.2, R904.2
unnamed: C912.2, R905.2
unnamed: C914.2, U903.2, U903.3
unnamed: C915.2, J901.2, R907.2
unnamed: C916.2, J901.6, R908.2
unnamed: D101.1, D102.2, F101.1
unnamed: D301.1, F301.1, J301.8
unnamed: D302.1, F302.1, J302.8
unnamed: D303.1, F303.1, J303.8
unnamed: D304.1, F304.1, J304.8
unnamed: D902.2, L901.1, U906.1
unnamed: F801.2, J801.4
unnamed: J301.3, U301.14
unnamed: J301.4, U301.13
unnamed: J302.3, U301.7
unnamed: J302.4, U301.8
unnamed: J303.3, U302.14
unnamed: J303.4, U302.13
unnamed: J304.3, U302.7
unnamed: J304.4, U302.8
unnamed: J801.2, Q801.3, U802.2
unnamed: J901.3, U903.8
unnamed: J901.4, R906.1, U903.5
unnamed: J902.8, RN801.1
unnamed: J902.9, RN801.2
unnamed: J902.10, RN801.3
unnamed: J902.11, RN801.4
unnamed: J902.12, RN802.1
unnamed: J902.15, RN802.2
unnamed: J902.16, RN802.3
unnamed: J902.17, RN802.4
unnamed: J902.18, RN803.1
unnamed: J902.19, RN803.2
unnamed: J902.20, RN803.3
unnamed: J902.24, RN803.4
unnamed: J902.25, RN804.1
unnamed: J902.26, RN804.2
unnamed: J902.27, RN804.3
unnamed: J902.28, RN804.4
unnamed: J902.30, RN805.1
unnamed: J902.31, R805.2
unnamed: J902.32, RN805.2
unnamed: J902.33, RN805.3
unnamed: J902.34, RN805.4
unnamed: Q301.1, R302.2
unnamed: Q801.1, U802.6
unnamed: Q801.2, R804.2
unnamed: R201.1, U201.3
unnamed: R202.2, R203.1, U201.5
unnamed: R302.1, R303.2, U404.12
unnamed: R402.2, U403.3, U404.23
unnamed: R403.2, U403.4, U404.24
unnamed: R802.2, U801.6, U802.4
unnamed: R803.2, U801.5, U802.5
unnamed: R902.2, U901.6
unnamed: R903.2, U901.7
unnamed: R904.1, R905.1, R906.2, U903.4
unnamed: R912.2, U904.3
unnamed: R913.2, U904.9
unnamed: U501.1, Y501.2
unnamed: U501.2, Y501.1
