sittner/ovng-build/(commit log)

2020-12-01 added kicad files
    [5Vsupply.sch, AudioOut.sch, BeagleBone.sch, MotionSens.sch, OneWire.sch, OpenVario.kicad_pcb, OpenVario.sch, PressSens.sch]
2020-12-01 moved project files to project folder
    [5Vsupply.sch, AudioOut.sch, BeagleBone.sch, MotionSens.sch, OneWire.sch, OpenVario.kicad_pcb, OpenVario.sch, PressSens.sch]
2020-12-01 added 3d models of custom parts
    [OpenVario.kicad_pcb]
2020-12-01 added partlist
    [partlist.ods]
2020-12-01 added stl files for printing the housing
    [housing-base.stl, housing-top.stl]
2020-12-01 added stl files sensor-block and display spacer STLs
    [display-spacer.stl, sensor-block.stl]
2020-12-03 renamed ovng-overlays, detect device tree file, be verbose on loading files on bootloader
2020-12-03 fixed housing for use with BeagleBone green (not wireless)
2020-12-03 updated stl files
    [housing-base.stl, housing-top.stl]
2020-12-04 fixed label alignment
    [housing-base.stl, housing-top.stl]
2020-12-04 added schematic and placement as pdf
2020-12-05 added production files for sensor-block
    [sensor-block.stp]
2020-12-14 added tech drawing for display spacer
2020-12-14 backport KRT2 device support
2020-12-16 added NLS support (en+de)
2020-12-21 create dest directory in weston-calibrator-helper
2021-04-24 updated icm20948 driver
2022-04-04 updated pcb file
    [OpenVario.kicad_pcb]
2022-04-04 added display spacer cut for emi shielding conductor
2022-04-04 added printable version of SensorBlock
    [SensorBlock.FCStd, sensor-block.stl, sensor-block.stp]
